janusnaefus/A-modular-USB-connected-operant-conditioning-apparatus-for-fishes/README.md

# A-modular-USB-connected-operant-conditioning-apparatus-for-fishes
Software and hardware blueprints for the corresponding publication in Behavioral Ecology and Sociobiology
