janusnaefus/A-modular-USB-connected-operant-conditioning-apparatus-for-fishes/button_plastic_parts/button_plastic_part_5_grey_opaque_3mm.dxf

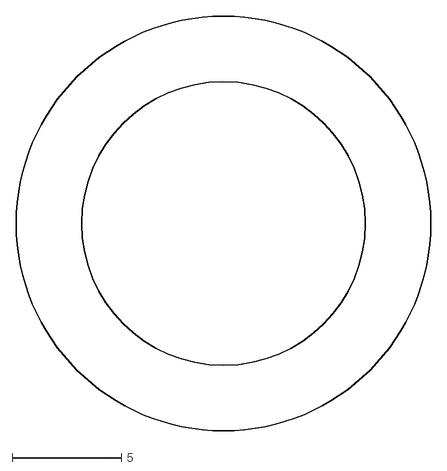
[picture p1: CAD file, 2020-05-28]
button_plastic_parts/button_plastic_part_5_grey_opaque_3mm.dxf
19.0 x 19.0
