janusnaefus/A-modular-USB-connected-operant-conditioning-apparatus-for-fishes/feeder_box_cutting.dxf

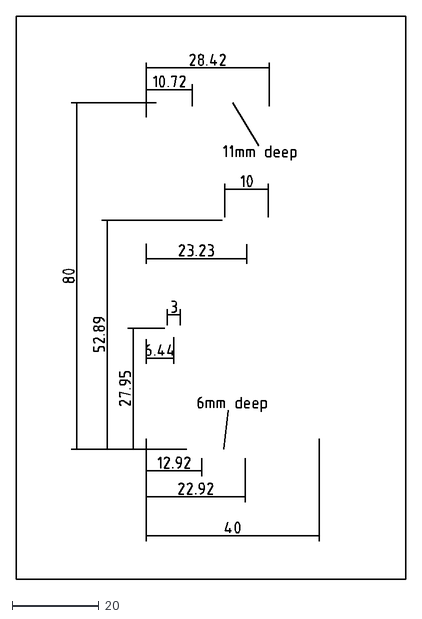
[picture p2: CAD file, 2020-05-28]
feeder_box_cutting.dxf
90.0 x 130.0
