janusnaefus/A-modular-USB-connected-operant-conditioning-apparatus-for-fishes/feeder_plastic_parts/feeder_plastic_parts_1,4,5,6,7,8_transparent_clear_2,5mm.dxf

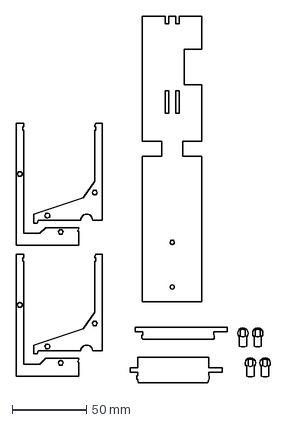
[picture p3: CAD file, 2020-05-28]
feeder_plastic_parts/feeder_plastic_parts_1,4,5,6,7,8_transparent_clear_2,5mm.dxf
171.3 x 246.3 mm
