janusnaefus/A-modular-USB-connected-operant-conditioning-apparatus-for-fishes/button_box_cutting.dxf

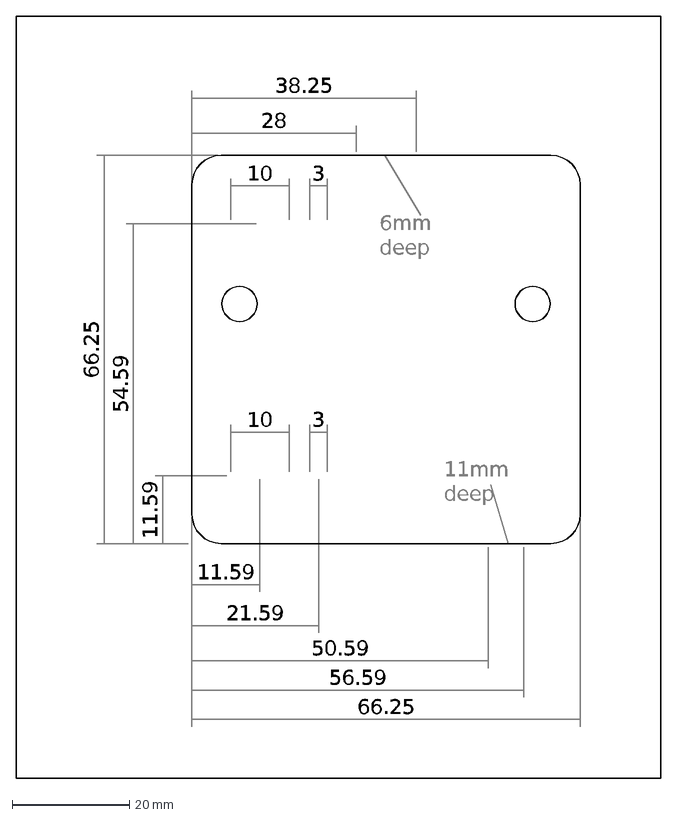
[picture p4: CAD file, 2020-05-28]
button_box_cutting.dxf
11.59
21.59
50.59
56.59
66.25
54.59
28
38.25
6mm deep
11mm deep
10
3
