janusnaefus/A-modular-USB-connected-operant-conditioning-apparatus-for-fishes/feeder_plastic_parts/feeder_plastic_parts_composition.dxf

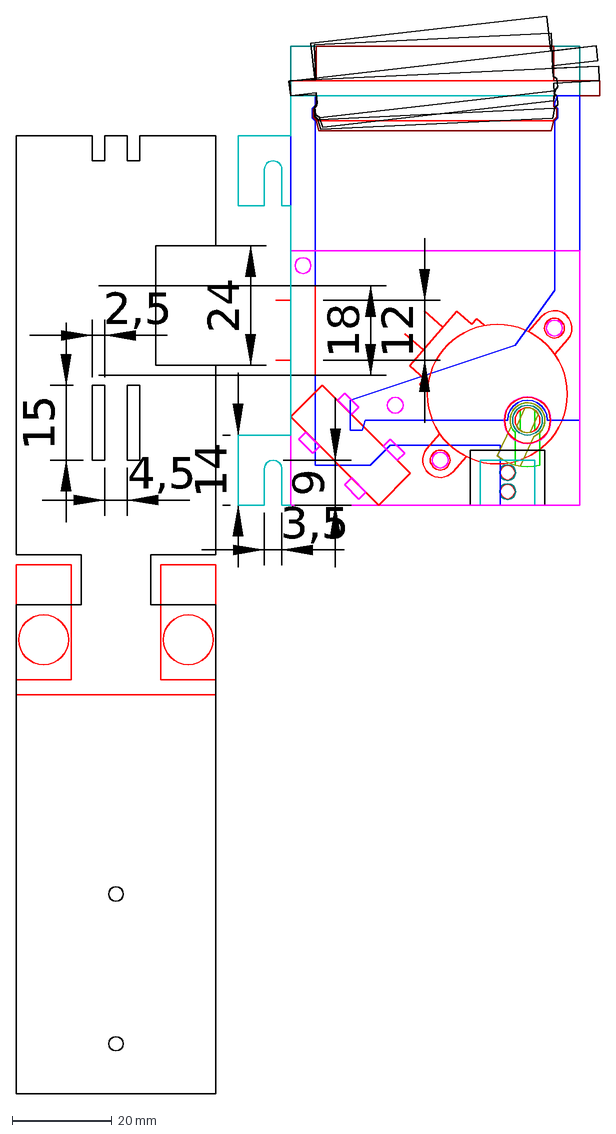
[picture p6: CAD file, 2020-05-28]
feeder_plastic_parts/feeder_plastic_parts_composition.dxf
14
18
9
2,5
4,5
15
12
24
3,5
