janusnaefus/A-modular-USB-connected-operant-conditioning-apparatus-for-fishes/button_plastic_parts/button_plastic_part_1_transparent_clear_2.5mm.dxf

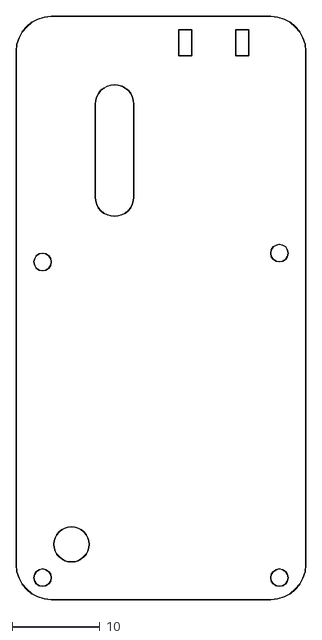
[picture p7: CAD file, 2020-05-28]
button_plastic_parts/button_plastic_part_1_transparent_clear_2.5mm.dxf
33.0 x 66.5
