janusnaefus/A-modular-USB-connected-operant-conditioning-apparatus-for-fishes/feeder_plastic_parts/feeder_plastic_parts_2,3_transparent_clear_2,0mm.dxf

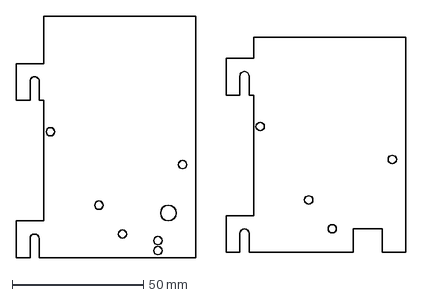
[picture p8: CAD file, 2020-05-28]
feeder_plastic_parts/feeder_plastic_parts_2,3_transparent_clear_2,0mm.dxf
148.5 x 92.0 mm
