janusnaefus/A-modular-USB-connected-operant-conditioning-apparatus-for-fishes/button_plastic_parts/button_plastic_part_4_transparent_clear_2.5mm.dxf

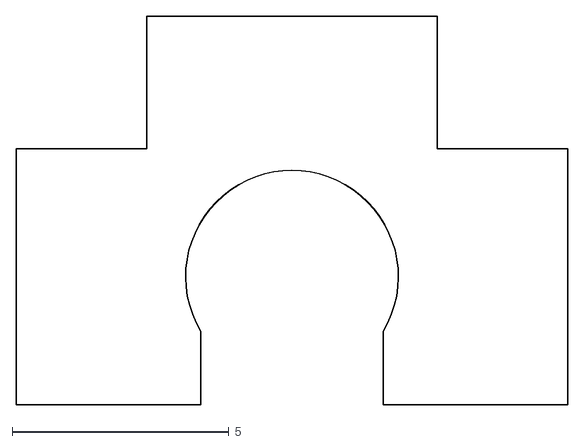
[picture p9: CAD file, 2020-05-28]
button_plastic_parts/button_plastic_part_4_transparent_clear_2.5mm.dxf
12.7 x 8.95
