janusnaefus/A-modular-USB-connected-operant-conditioning-apparatus-for-fishes/button_plastic_parts/button_plastic_parts_composition.dxf

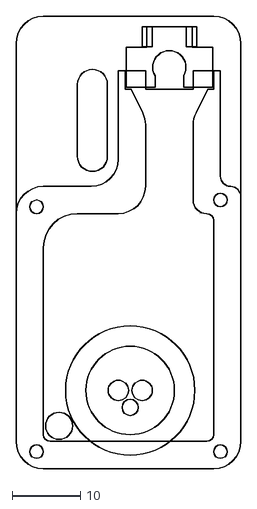
[picture p10: CAD file, 2020-05-28]
button_plastic_parts/button_plastic_parts_composition.dxf
33.0 x 66.5
