janusnaefus/A-modular-USB-connected-operant-conditioning-apparatus-for-fishes/button_plastic_parts/button_plastic_part_2_grey_opaque_3mm.dxf

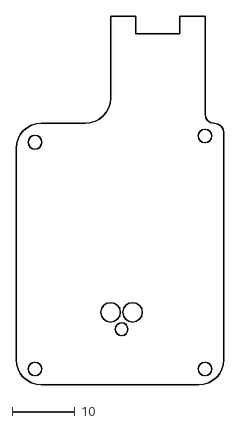
[picture p11: CAD file, 2020-05-28]
button_plastic_parts/button_plastic_part_2_grey_opaque_3mm.dxf
33.0 x 58.5
