janusnaefus/A-modular-USB-connected-operant-conditioning-apparatus-for-fishes/button_pcbs/button_sensor_side.brd

## EAGLE design button_pcbs/button_sensor_side.brd (2020-05-28)

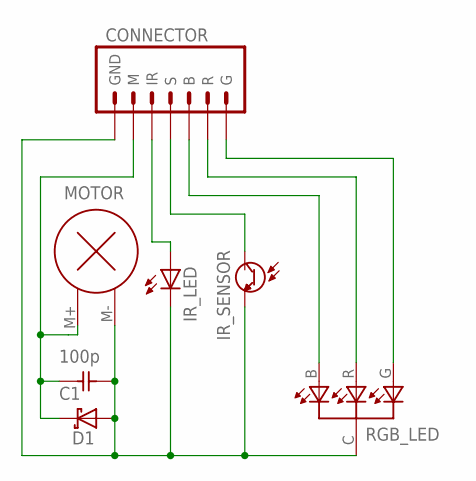
[picture p12: schematic button_sensor_side.sch]

Parts:
C1: 100p; C0805
CONNECTOR: CONNECTOR_PADS
D1: DIODE_SCHOTTKY; NSR0530HT1G_SCHOTTKY_DIODE
IR_LED: TCR5000_EMITTER; TCR5000_IR_EMITTER
IR_SENSOR: TCR5000_SENSOR; TCR5000_IR_SENSOR
MOTOR: VIBRATION_MOTOR
RGB_LED: APTF1616SEJ3ZGGVBDC_RBG_LED_SMT; APTF1616SEJ3ZGGVBDC_RGB_LED_SMT

Connections:
GND: C1.2, CONNECTOR.GND, CONNECTOR.GND_ (GND), D1.A, IR_LED.C, IR_SENSOR.E, MOTOR.M- (-), RGB_LED.C
unnamed: C1.1, CONNECTOR.M, D1.C, MOTOR.M+ (+)
unnamed: CONNECTOR.S, IR_SENSOR.C
unnamed: CONNECTOR.IR, IR_LED.A
unnamed: CONNECTOR.B, RGB_LED.B (BLUE)
unnamed: CONNECTOR.R, RGB_LED.R (RED)
unnamed: CONNECTOR.G, RGB_LED.G (GREEN)

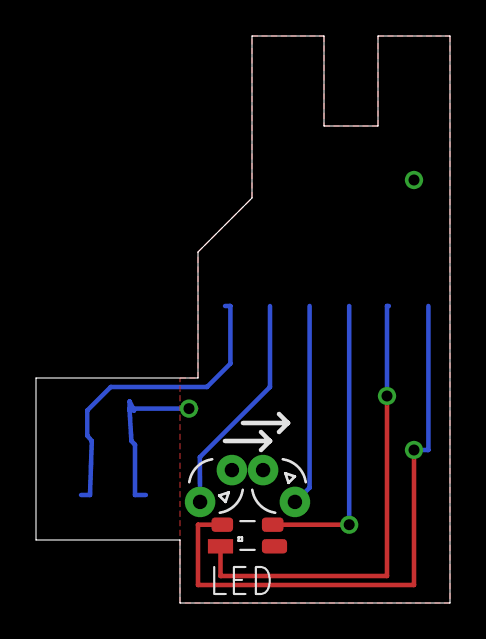
[picture p13: board button_sensor_side.brd from above]

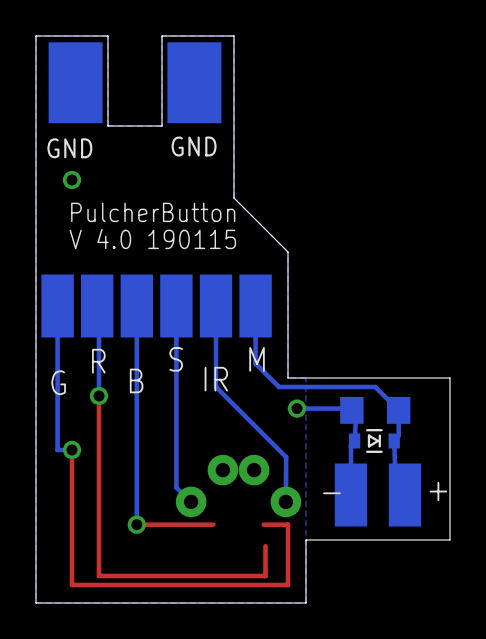
[picture p14: board button_sensor_side.brd from below]

Board: 2 copper layers, 23.0 x 31.5 mm, 7 parts (2 on the bottom side), 7 nets.
