janusnaefus/A-modular-USB-connected-operant-conditioning-apparatus-for-fishes/button_pcbs/button_microcontroller_side.brd

## EAGLE design button_pcbs/button_microcontroller_side.brd (2020-05-28)

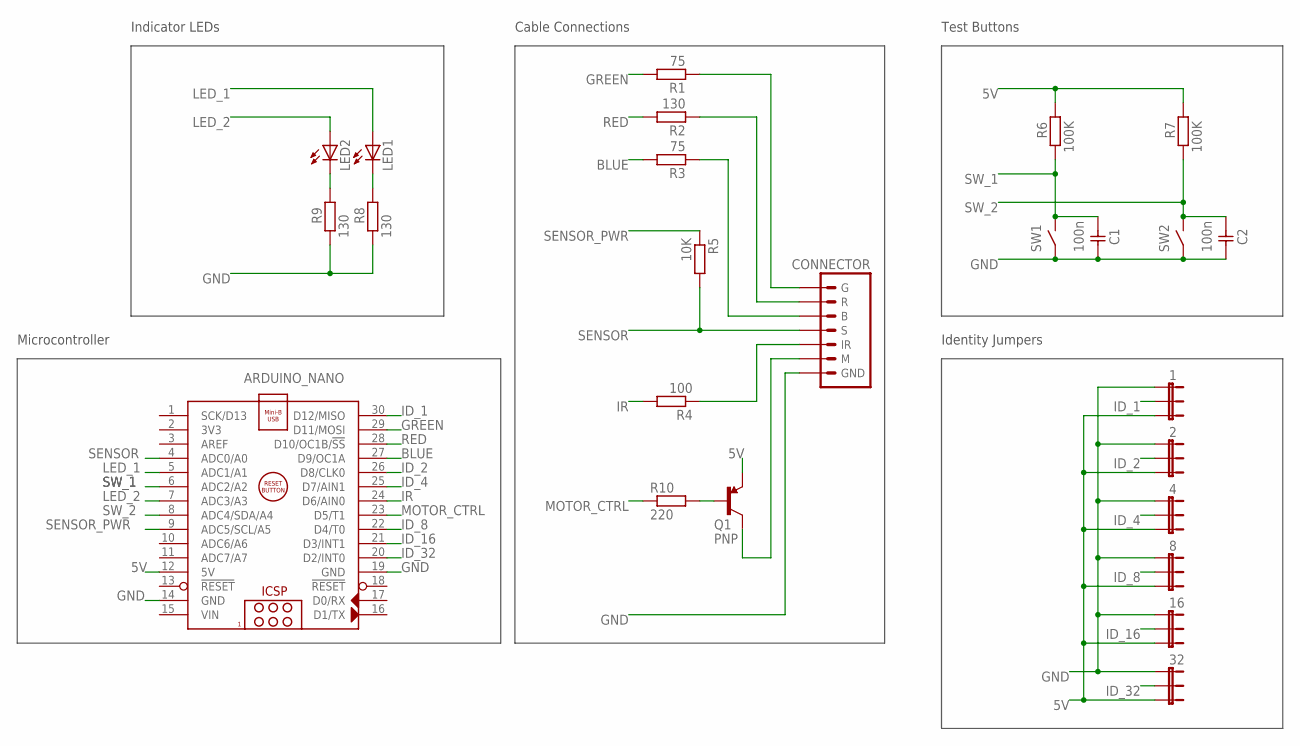
[picture p15: schematic button_microcontroller_side.sch]

Parts:
1, 2, 4, 8, 16, 32: JP2E; JP2
ARDUINO_NANO: ARDUINO_NANO
C1, C2: 100n; CAPACITOR
CONNECTOR: CONNECTOR_PADSHOLES; CONNECTOR_ARDUINO_SIDE
LED1, LED2: LED_3MM; TCR5000_IR_EMITTER
Q1: PNP; TO92-
R1, R3: 75; 0204/7
R2, R8, R9: 130; 0204/7
R4: 100; 0204/7
R5: 10K; 0204/7
R6, R7: 100K; 0204/7
R10: 220; 0204/7
SW1, SW2: BUTTON; KS-01Q-01_BUTTON

Connections:
5V: 1.3, 2.3, 4.3, 8.3, 16.3, 32.3, ARDUINO_NANO.12 (5V), Q1.E, R6.2, R7.2
BLUE: ARDUINO_NANO.27 (D9/OC1A), R3.2
GND: 1.1, 2.1, 4.1, 8.1, 16.1, 32.1, ARDUINO_NANO.14 (GND), ARDUINO_NANO.19 (GND), C1.P$1 (1), C2.P$1 (1), CONNECTOR.GND, R8.1, R9.1, SW1.1, SW1.3 (1), SW2.1, SW2.3 (1)
GREEN: ARDUINO_NANO.29 (D11/MOSI), R1.2
ID_1: 1.2, ARDUINO_NANO.30 (D12/MISO)
ID_2: 2.2, ARDUINO_NANO.26 (D8/CLK0)
ID_4: 4.2, ARDUINO_NANO.25 (D7/AIN1)
ID_8: 8.2, ARDUINO_NANO.22 (D4/T0)
ID_16: 16.2, ARDUINO_NANO.21 (D3/INT1)
ID_32: 32.2, ARDUINO_NANO.20 (D2/INT0)
IR: ARDUINO_NANO.24 (D6/AIN0), R4.2
LED_1: ARDUINO_NANO.5 (ADC1/A1), LED1.A
LED_2: ARDUINO_NANO.7 (ADC3/A3), LED2.A
MOTOR: CONNECTOR.M, Q1.C
MOTOR_CTRL: ARDUINO_NANO.23 (D5/T1), R10.1
unnamed: CONNECTOR.IR, R4.1
unnamed: CONNECTOR.B, R3.1
unnamed: CONNECTOR.R, R2.1
unnamed: CONNECTOR.G, R1.1
unnamed: LED1.C, R8.2
unnamed: LED2.C, R9.2
unnamed: Q1.B, R10.2
RED: ARDUINO_NANO.28 (D10/OC1B/!SS), R2.2
SENSOR: ARDUINO_NANO.4 (ADC0/A0), CONNECTOR.S, R5.2
SENSOR_PWR: ARDUINO_NANO.9 (ADC5/SCL/A5), R5.1
SW_1: ARDUINO_NANO.6 (ADC2/A2), C1.P$2 (2), R6.1, SW1.2, SW1.4 (2)
SW_2: ARDUINO_NANO.8 (ADC4/SDA/A4), C2.P$2 (2), R7.1, SW2.2, SW2.4 (2)
VIN: ARDUINO_NANO.15 (VIN)

Notes on the sheet:
Indicator LEDs
Test Buttons
Cable Connections
Identity Jumpers
Microcontroller

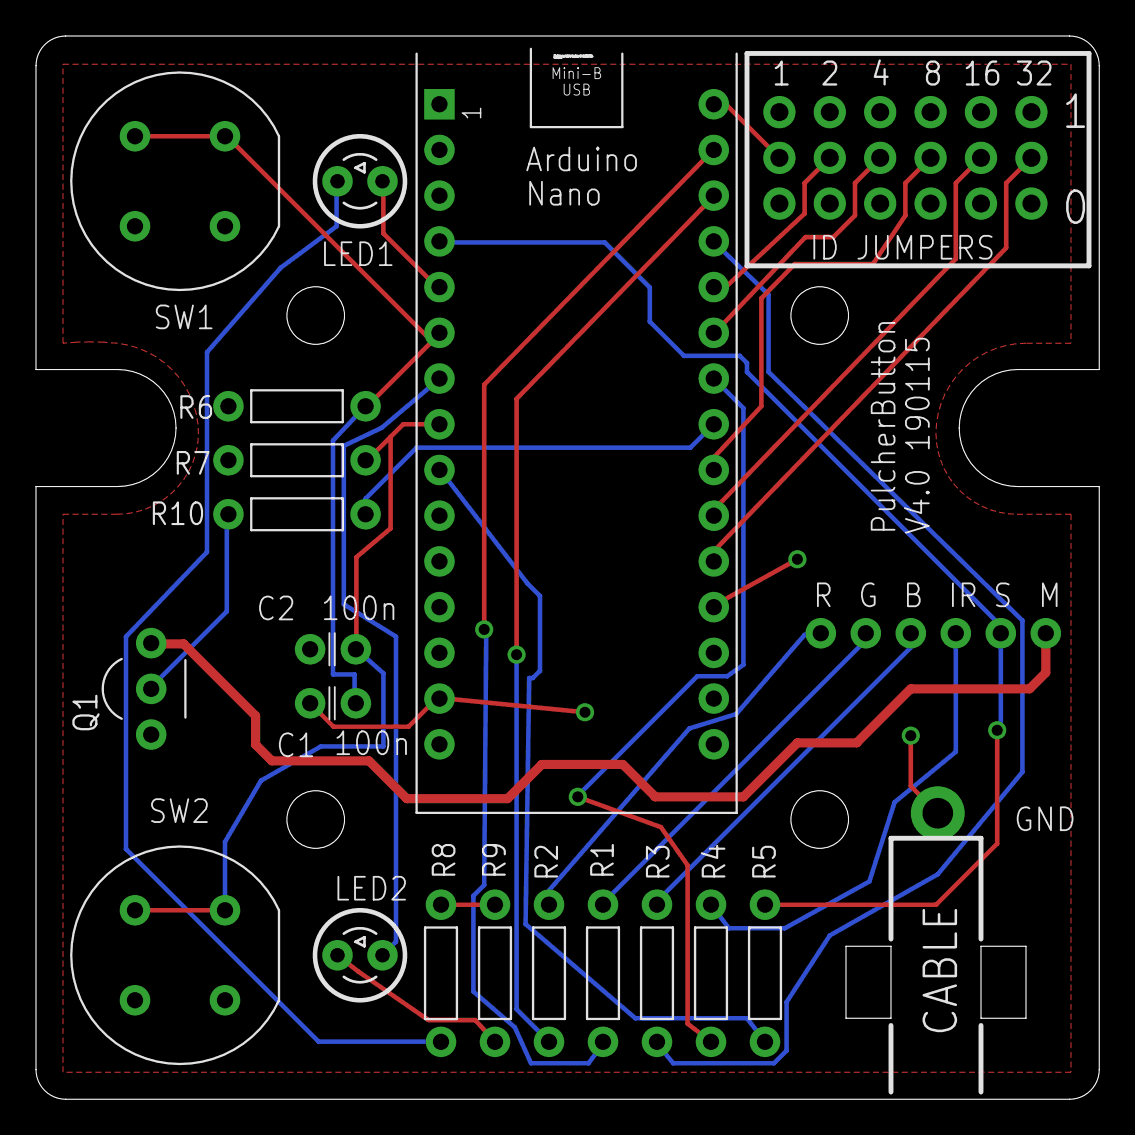
[picture p16: board button_microcontroller_side.brd from above]

Board: 2 copper layers, 59.1 x 59.1 mm, 25 parts (0 on the bottom side), 27 nets.
