janusnaefus/A-modular-USB-connected-operant-conditioning-apparatus-for-fishes/feeder_pcbs/feeder_microcontroller_side.brd

## EAGLE design feeder_pcbs/feeder_microcontroller_side.brd (2020-05-28)

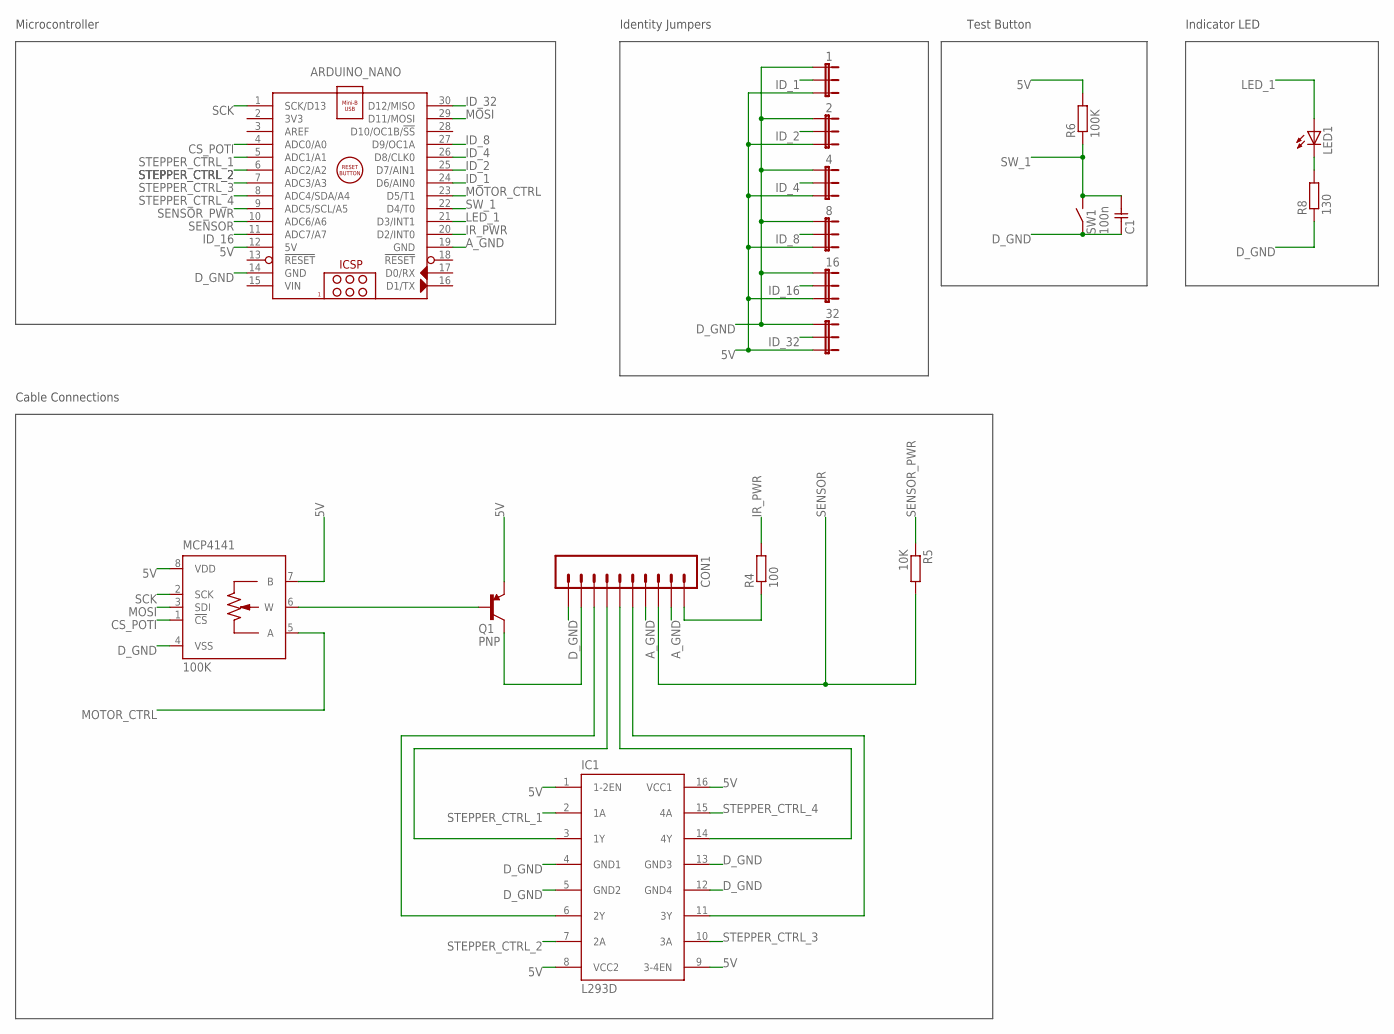
[picture p17: schematic feeder_microcontroller_side.sch]

Parts:
1, 2, 4, 8, 16, 32: JP2E; JP2
ARDUINO_NANO: ARDUINO_NANO
C1: 100n; CAPACITOR
CON1: CON_10; CON_10P_1.25_ALIEXPRESS
IC1: L293D; DIL16
LED1: LED_3MM; TCR5000_IR_EMITTER
MCP4141: 100K; DIL08
Q1: PNP; TO92-
R4: 100; 0204/7
R5: 10K; 0204/7
R6: 100K; 0204/7
R8: 130; 0204/7
SW1: BUTTON; KS-01Q-01_BUTTON

Connections:
5V: 1.3, 2.3, 4.3, 8.3, 16.3, 32.3, ARDUINO_NANO.12 (5V), IC1.1 (1-2EN), IC1.8 (VCC2), IC1.9 (3-4EN), IC1.16 (VCC1), MCP4141.7 (B), MCP4141.8 (VDD), Q1.E, R6.2
A_GND: ARDUINO_NANO.19 (GND), CON1.2, CON1.4
CS_POTI: ARDUINO_NANO.4 (ADC0/A0), MCP4141.1 (!CS)
D_GND: 1.1, 2.1, 4.1, 8.1, 16.1, 32.1, ARDUINO_NANO.14 (GND), C1.P$1 (1), CON1.10, IC1.4 (GND1), IC1.5 (GND2), IC1.12 (GND4), IC1.13 (GND3), MCP4141.4 (VSS), R8.1, SW1.1, SW1.3 (1)
ID_1: 1.2, ARDUINO_NANO.24 (D6/AIN0)
ID_2: 2.2, ARDUINO_NANO.25 (D7/AIN1)
ID_4: 4.2, ARDUINO_NANO.26 (D8/CLK0)
ID_8: 8.2, ARDUINO_NANO.27 (D9/OC1A)
ID_16: 16.2, ARDUINO_NANO.11 (ADC7/A7)
ID_32: 32.2, ARDUINO_NANO.30 (D12/MISO)
IR+: CON1.1, R4.1
IR_PWR: ARDUINO_NANO.20 (D2/INT0), R4.2
LED_1: ARDUINO_NANO.21 (D3/INT1), LED1.A
MOSI: ARDUINO_NANO.29 (D11/MOSI), MCP4141.3 (SDI)
MOTOR_CTRL: ARDUINO_NANO.23 (D5/T1), MCP4141.5 (A)
MOTOR_SUPPLY: CON1.9, Q1.C
unnamed: MCP4141.6 (W), Q1.B
unnamed: LED1.C, R8.2
SCK: ARDUINO_NANO.1 (SCK/D13), MCP4141.2 (SCK)
SENSOR: ARDUINO_NANO.10 (ADC6/A6), CON1.3, R5.2
SENSOR_PWR: ARDUINO_NANO.9 (ADC5/SCL/A5), R5.1
STEPPER_CTRL_1: ARDUINO_NANO.5 (ADC1/A1), IC1.2 (1A)
STEPPER_CTRL_2: ARDUINO_NANO.6 (ADC2/A2), IC1.7 (2A)
STEPPER_CTRL_3: ARDUINO_NANO.7 (ADC3/A3), IC1.10 (3A)
STEPPER_CTRL_4: ARDUINO_NANO.8 (ADC4/SDA/A4), IC1.15 (4A)
STEPPER_PWR_1: CON1.7, IC1.3 (1Y)
STEPPER_PWR_2: CON1.8, IC1.6 (2Y)
STEPPER_PWR_3: CON1.5, IC1.11 (3Y)
STEPPER_PWR_4: CON1.6, IC1.14 (4Y)
SW_1: ARDUINO_NANO.22 (D4/T0), C1.P$2 (2), R6.1, SW1.2, SW1.4 (2)
VIN: ARDUINO_NANO.15 (VIN)

Notes on the sheet:
Indicator LED
Test Button
Cable Connections
Identity Jumpers
Microcontroller

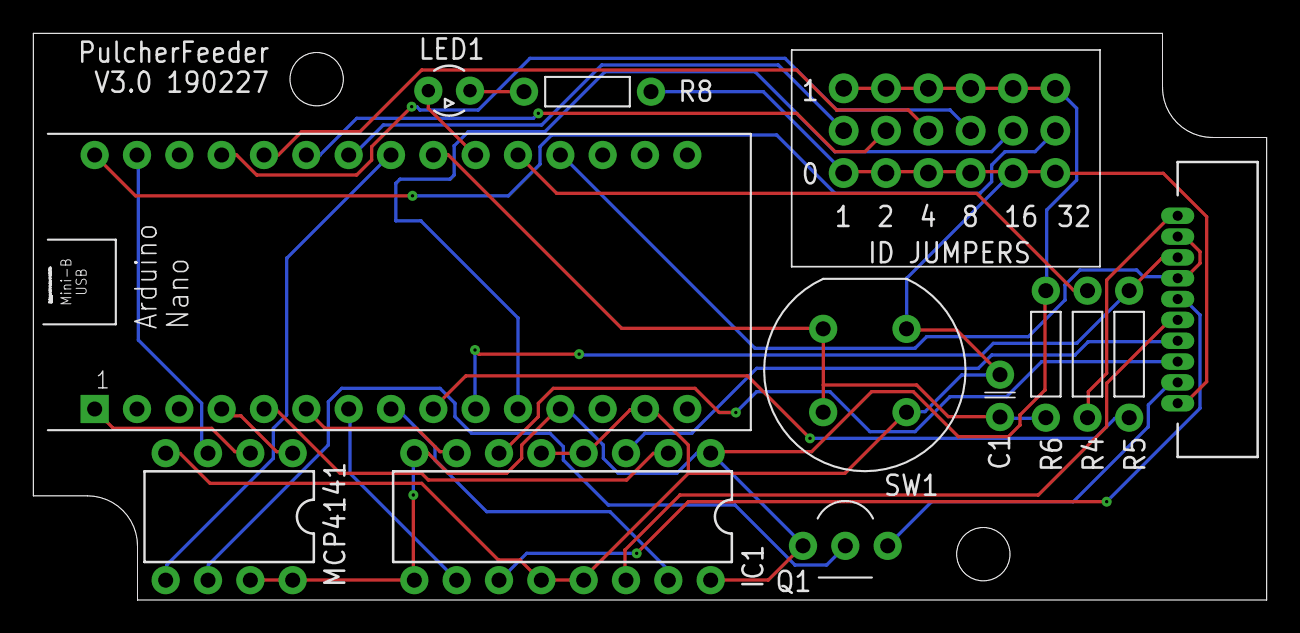
[picture p18: board feeder_microcontroller_side.brd from above]

Board: 2 copper layers, 74.0 x 34.0 mm, 18 parts (0 on the bottom side), 30 nets.
