janusnaefus/A-modular-USB-connected-operant-conditioning-apparatus-for-fishes/feeder_pcbs/feeder_container_side.brd

## EAGLE design feeder_pcbs/feeder_container_side.brd (2020-05-28)

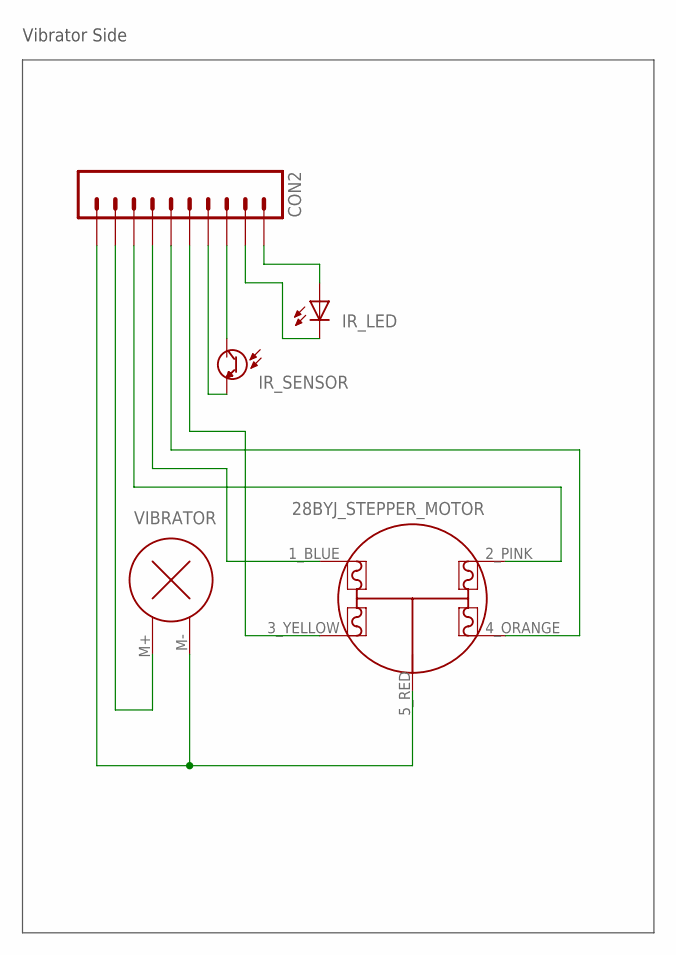
[picture p19: schematic feeder_container_side.sch]

Parts:
28BYJ_STEPPER_MOTOR: 28BYJ
CON2: CON_10; CON_10P_1.25_ALIEXPRESS
IR_LED: TCR5000_EMITTER; TCR5000_IR_EMITTER
IR_SENSOR: TCR5000_SENSOR; TCR5000_IR_SENSOR
VIBRATOR: VIBRATION_MOTORVIBRATION_MOTOR_LARGE; VIBRATION_MOTOR_LARGE

Connections:
GND: 28BYJ_STEPPER_MOTOR.5_RED (5_COM), CON2.10, VIBRATOR.M- (-)
IR+: CON2.1, IR_LED.A
IR-: CON2.2, IR_LED.C
MOTOR+: CON2.9, VIBRATOR.M+ (+)
SENSOR+: CON2.3, IR_SENSOR.C
SENSOR-: CON2.4, IR_SENSOR.E
STEPPER_1: 28BYJ_STEPPER_MOTOR.1_BLUE (1), CON2.7
STEPPER_2: 28BYJ_STEPPER_MOTOR.2_PINK (2), CON2.8
STEPPER_3: 28BYJ_STEPPER_MOTOR.3_YELLOW (3), CON2.5
STEPPER_4: 28BYJ_STEPPER_MOTOR.4_ORANGE (4), CON2.6

Notes on the sheet:
Vibrator Side

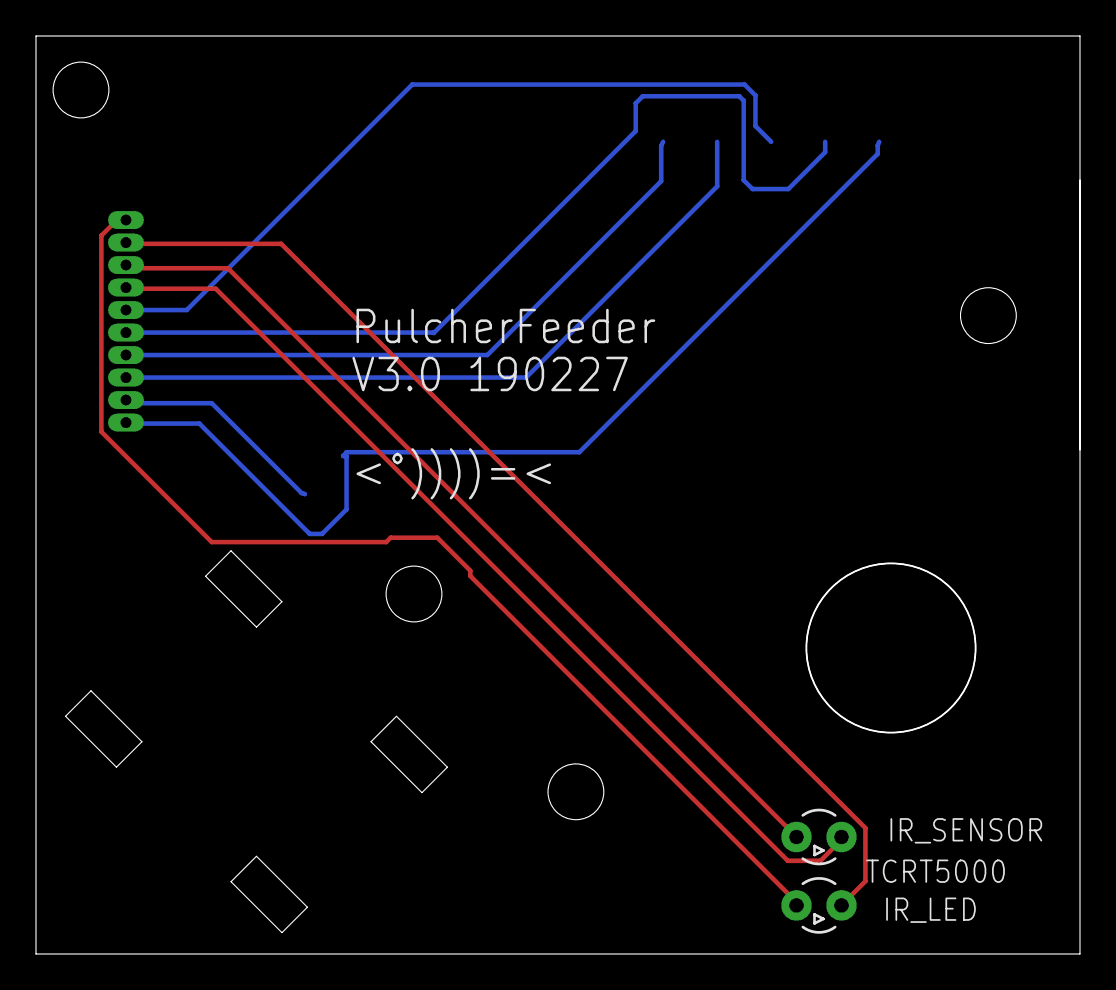
[picture p20: board feeder_container_side.brd from above]

Board: 2 copper layers, 58.0 x 51.0 mm, 5 parts (1 on the bottom side), 10 nets.
