janusnaefus/A-modular-USB-connected-operant-conditioning-apparatus-for-fishes/controlling_program_files/main_control_commands.py

import os

os.system('echo')
os.system('echo')
os.system('echo copying...')
os.system('rm /home/pi/Desktop/feeder_launcher_stage_3.sh')
os.system('cp /home/pi/HasliJannaef/to_upload/feeder_launcher_stage_3.sh /home/pi/Desktop/feeder_launcher_stage_3.sh')
os.system('echo done copying.')
os.system('echo')
os.system('echo')
